tigmit/Split-Numpad/Documentation/esp32-wroom-32.jpg.webp

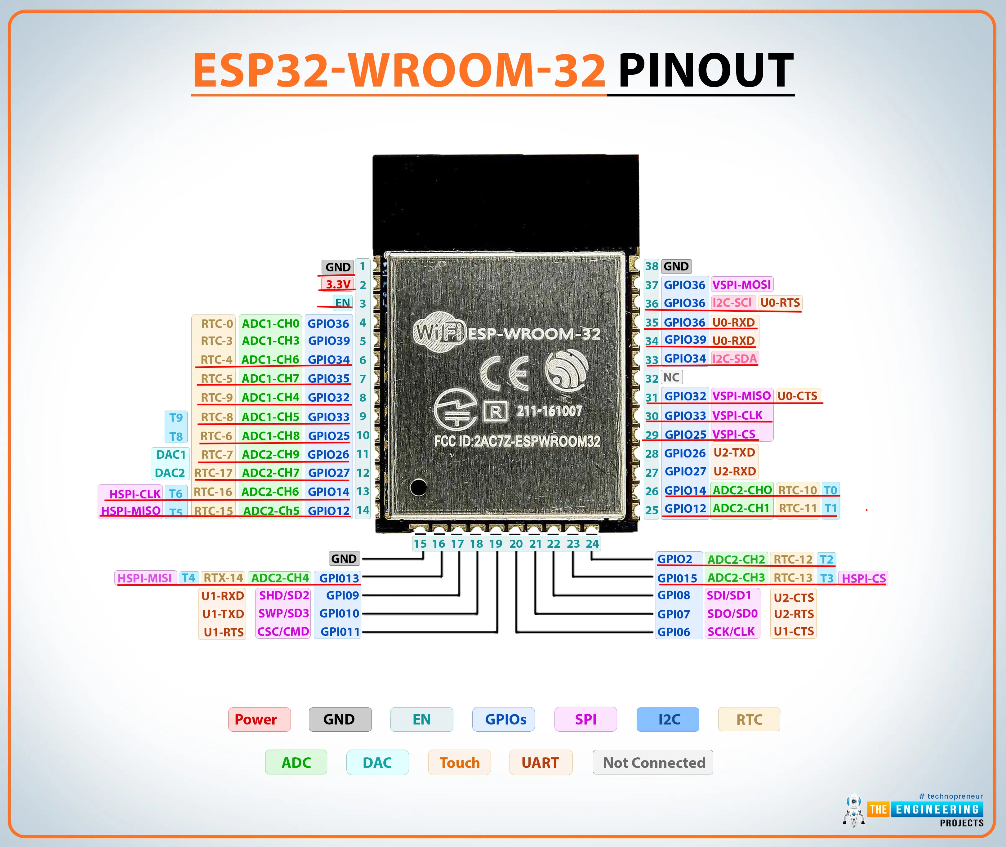
Documentation/esp32-wroom-32.jpg.webp
