tigmit/Split-Numpad/Documentation/numpad3dView.png

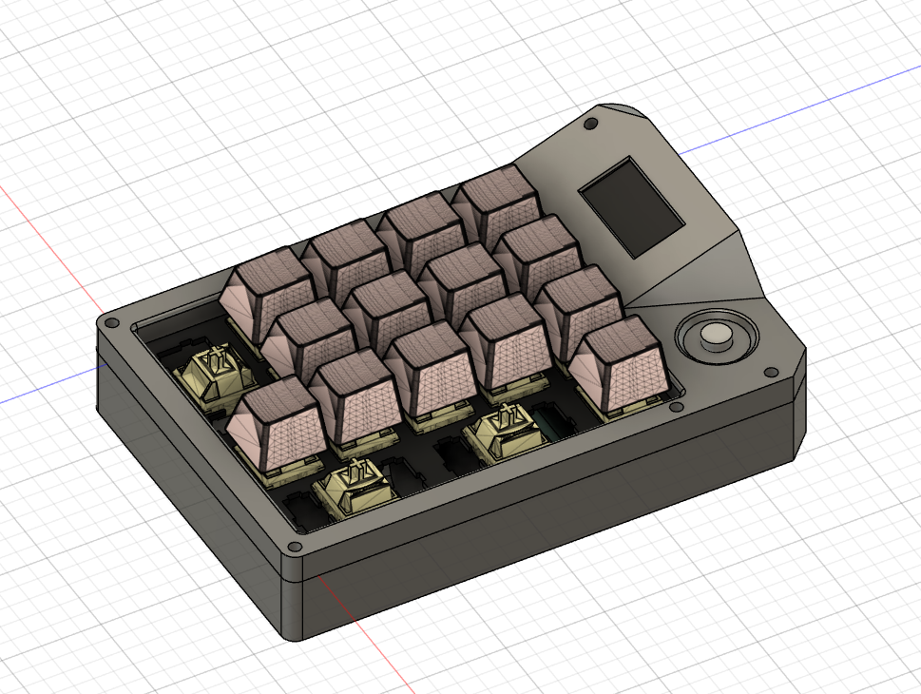
Documentation/numpad3dView.png
