tigmit/Split-Numpad/README.md

# DIY NUMPAD -
#####    by TIGMIT

exampleImmage
