tigmit/Split-Numpad/Documentation/M3_Bolt_Countersink_Dimentions.webp

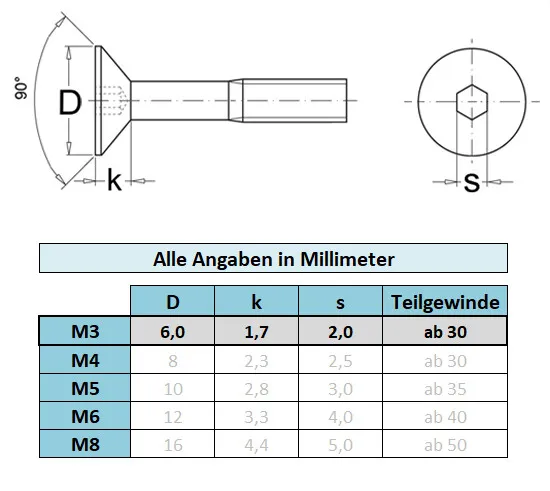
Documentation/M3_Bolt_Countersink_Dimentions.webp
