tigmit/Split-Numpad/Documentation/M3_Bolt_Dimentions.webp

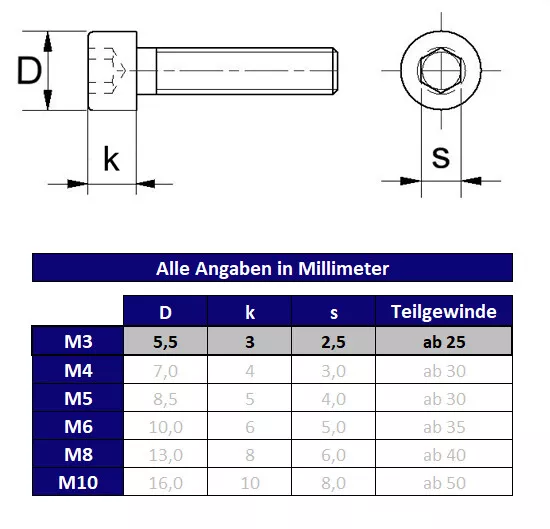
Documentation/M3_Bolt_Dimentions.webp
