tigmit/Split-Numpad/case_Design/Exports/numPadCase-keyplate.step

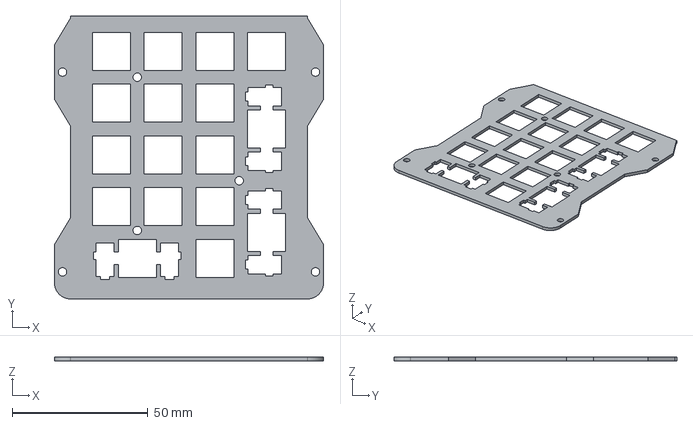
[picture p5: CAD file, 2024-10-12]
case_Design/Exports/numPadCase-keyplate.step
99.1 x 104.2 x 1.50 mm
