tigmit/Split-Numpad/Documentation/keyplate_MX_ONLY.dxf

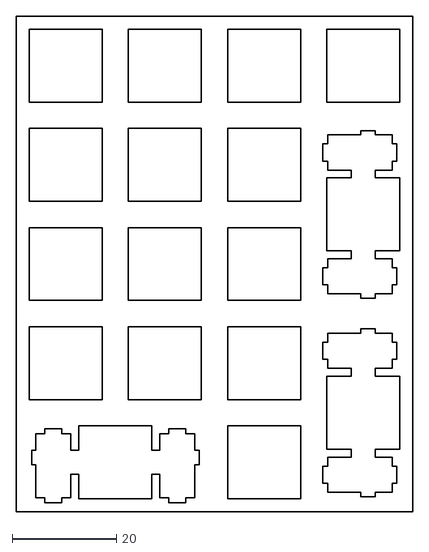
[picture p6: CAD file, 2024-09-06]
Documentation/keyplate_MX_ONLY.dxf
76.2 x 95.2
