tigmit/Split-Numpad/Power_Delivery_Module_V2/PowerDeliveryModule_V2/PowerDeliveryModule_V2.step

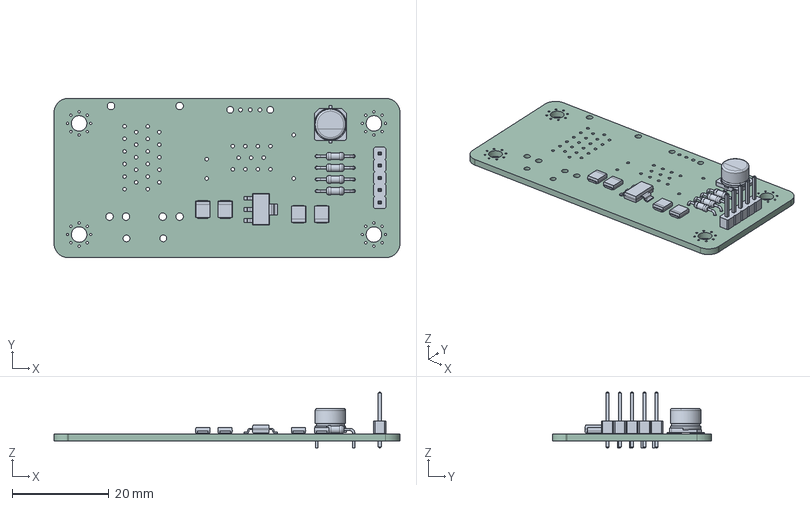
[picture p7: CAD file, 2024-09-06]
Power_Delivery_Module_V2/PowerDeliveryModule_V2/PowerDeliveryModule_V2.step
71.6 x 33.0 x 11.5 mm
CP_EIA-3528-12_Kemet-T x 4
R_Axial_DIN0204_L3.6mm_D1.6mm_P7.62mm_Horizontal x 4
CP_Elec_6.3x5.2
PinHeader_1x05_P2.54mm_Vertical
SOT-223
PowerDeliveryModule_V2_PCB
