tigmit/Split-Numpad/case_Design/Exports/numPadCase-Lid.stl

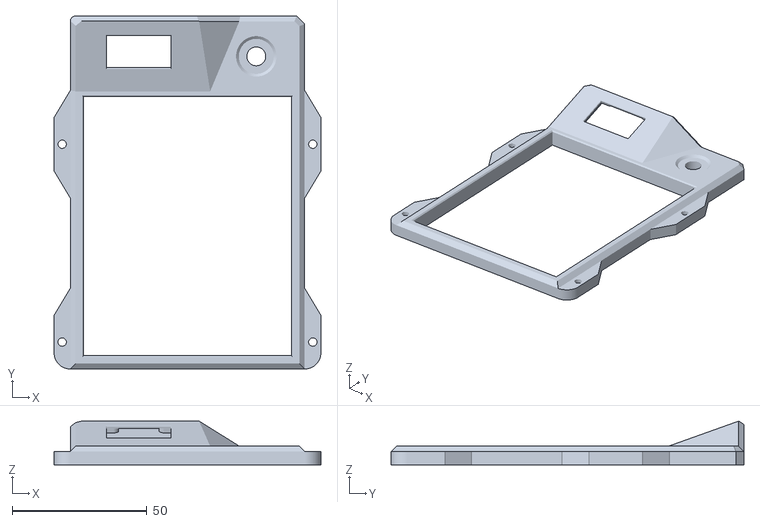
[picture p8: CAD file, 2024-10-12]
case_Design/Exports/numPadCase-Lid.stl
99.1 x 131.2 x 16.3
