tigmit/Split-Numpad/Documentation/PowerDeliveryBoard v2.step

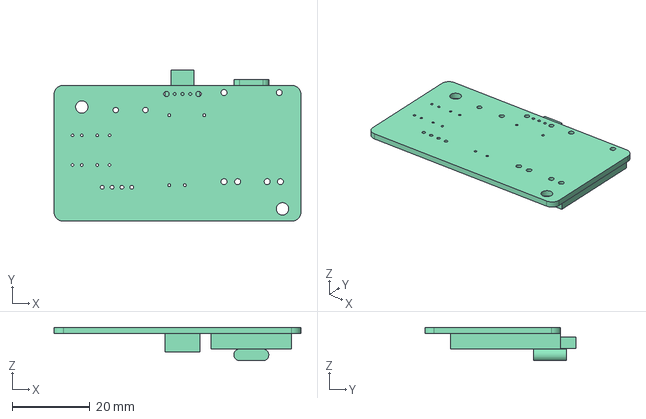
[picture p9: CAD file, 2024-07-21]
Documentation/PowerDeliveryBoard v2.step
63.5 x 38.9 x 8.60 mm
