tigmit/Split-Numpad/case_Design/Exports/numPadCase-uartLid.stl

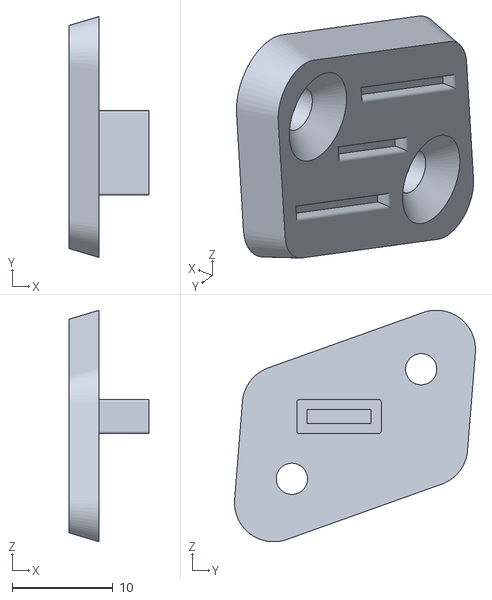
[picture p10: CAD file, 2024-10-12]
case_Design/Exports/numPadCase-uartLid.stl
8.00 x 24.0 x 23.0
