tigmit/Split-Numpad/Documentation/numpadPlate.dxf

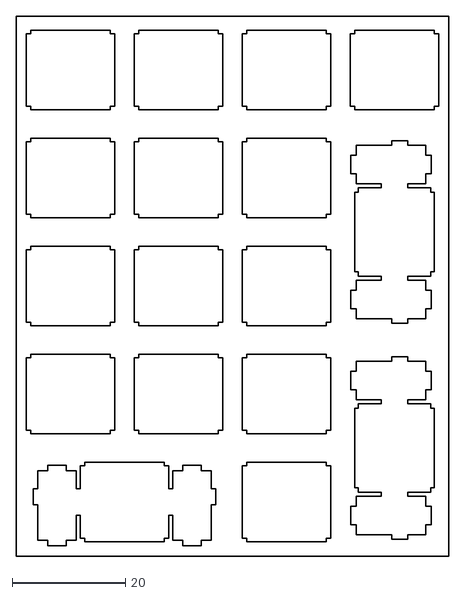
[picture p11: CAD file, 2024-07-21]
Documentation/numpadPlate.dxf
76.2 x 95.2
