tigmit/Split-Numpad/case_Design/Exports/numPadCase-bottomCase.stl

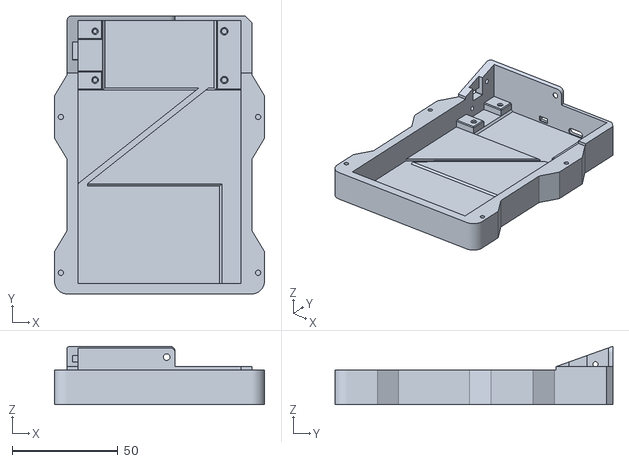
[picture p12: CAD file, 2024-10-12]
case_Design/Exports/numPadCase-bottomCase.stl
99.1 x 131.2 x 27.6
