tigmit/Split-Numpad/(list of files, cad)

Other CAD files:
case_Design/Exports/numPadCase-keyplate.dxf
case_Design/Exports/numPadCase-keyplate.stl
