tigmit/Split-Numpad/numpad_Schematics/numpad.kicad_pcb

## KiCad design numpad_Schematics/numpad.kicad_pcb (2024-10-12)

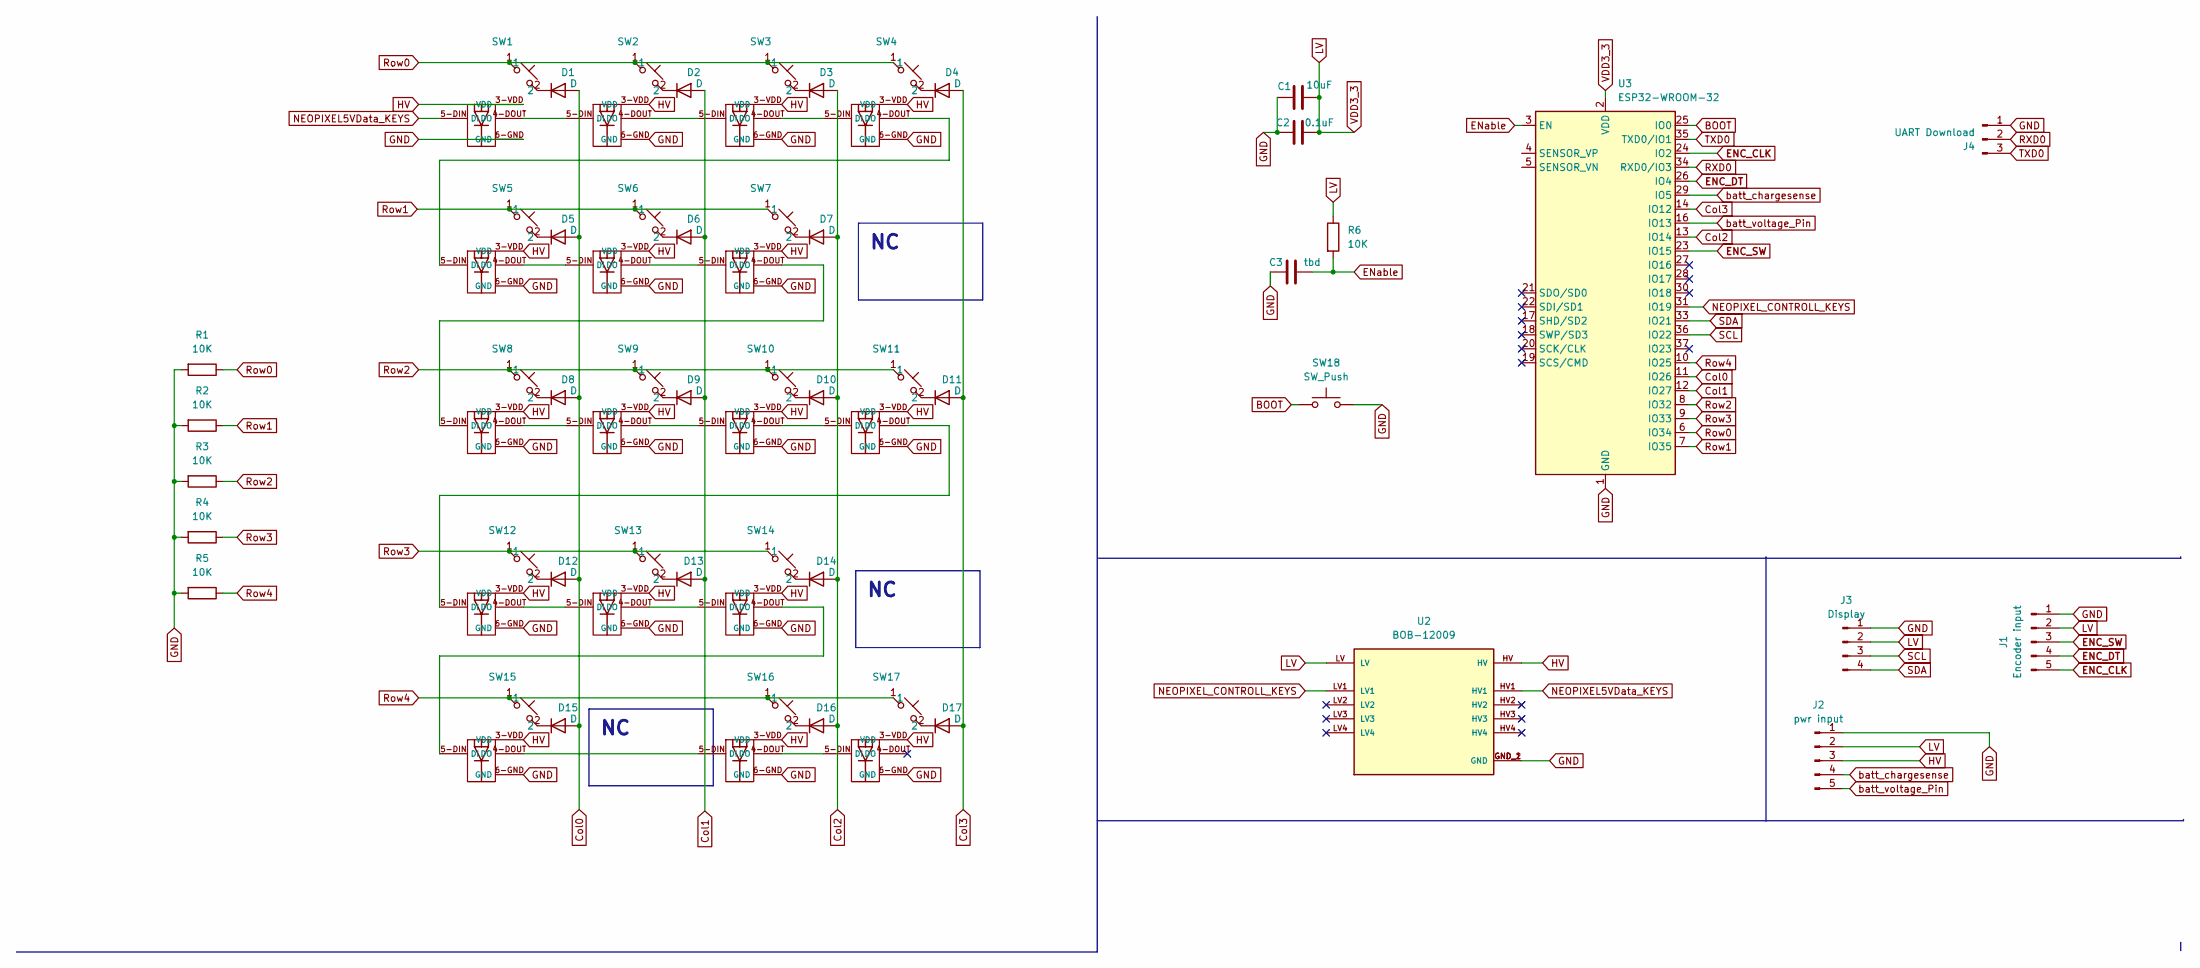
[picture p13: schematic numpad.kicad_sch]

Parts:
C1: 10uF; CP_EIA-3528-12_Kemet-T
C2: 0.1uF; CP_EIA-3528-12_Kemet-T
C3: tbd; CP_EIA-3528-12_Kemet-T
D1, D2, D3, D4, D5, D6, D7, D8, D9, D10, D11, D12, D13, D14, D15, D16, D17: D; Diode_SOD-123
J1: Encoder input; PinHeader_1x05_P2.54mm_Vertical
J2: pwr input; PinHeader_1x05_P2.54mm_Vertical
J3: Display; PinHeader_1x04_P2.54mm_Vertical
J4: UART Download; PinHeader_1x03_P2.54mm_Horizontal
R1, R2, R3, R4, R5, R6: 10K; R_Axial_DIN0204_L3.6mm_D1.6mm_P7.62mm_Horizontal
SW1, SW2, SW3, SW4, SW5, SW6, SW7, SW8, SW9, SW10, SW11, SW12, SW13, SW14, SW15, SW16, SW17: hotswap socket with neopixel
SW18: SW_Push; tigmit pushbutton
U2: BOB-12009; CONV_BOB-12009; PARTREV 01
U3: ESP32-WROOM-32; ESP32-WROOM-32 tigmit

Connections:
BOOT: SW18.1, U3.25 (IO0)
Col0: D1.2 (A), D5.2 (A), D8.2 (A), D12.2 (A), D15.2 (A), U3.11 (IO26)
Col1: D2.2 (A), D6.2 (A), D9.2 (A), D13.2 (A), U3.12 (IO27)
Col2: D3.2 (A), D7.2 (A), D10.2 (A), D14.2 (A), D16.2 (A), U3.13 (IO14)
Col3: D4.2 (A), D11.2 (A), D17.2 (A), U3.14 (IO12)
ENC_CLK: J1.5, U3.24 (IO2); also elsewhere on the board
ENC_DT: J1.4, U3.26 (IO4); also elsewhere on the board
ENC_SW: J1.3, U3.23 (IO15); also elsewhere on the board
ENable: C3.2, R6.2, U3.3 (EN)
GND: C1.1, C2.1, C3.1, J1.1, J2.1, J3.1, J4.1, R1.2, R2.2, R3.2, R4.2, R5.2, SW1.6-GND (GND), SW2.6-GND (GND), SW3.6-GND (GND), SW4.6-GND (GND), SW5.6-GND (GND), SW6.6-GND (GND), SW7.6-GND (GND), SW8.6-GND (GND), SW9.6-GND (GND), SW10.6-GND (GND), SW11.6-GND (GND), SW12.6-GND (GND), SW13.6-GND (GND), SW14.6-GND (GND), SW15.6-GND (GND), SW16.6-GND (GND), SW17.6-GND (GND), SW18.2, U2.GND_1 (GND), U2.GND_2 (GND), U3.1 (GND), U3.15 (GND), U3.38 (GND), U3.39 (GND); also elsewhere on the board
HV: J2.3, SW1.3-VDD (VDD), SW2.3-VDD (VDD), SW3.3-VDD (VDD), SW4.3-VDD (VDD), SW5.3-VDD (VDD), SW6.3-VDD (VDD), SW7.3-VDD (VDD), SW8.3-VDD (VDD), SW9.3-VDD (VDD), SW10.3-VDD (VDD), SW11.3-VDD (VDD), SW12.3-VDD (VDD), SW13.3-VDD (VDD), SW14.3-VDD (VDD), SW15.3-VDD (VDD), SW16.3-VDD (VDD), SW17.3-VDD (VDD), U2.HV; also elsewhere on the board
LV: C1.2, C2.2, J1.2, J2.2, J3.2, R6.1, U2.LV, U3.2 (VDD); also elsewhere on the board
NEOPIXEL5VData_KEYS: SW1.5-DIN (DI), U2.HV1; also elsewhere on the board
NEOPIXEL_CONTROLL_KEYS: U2.LV1, U3.31 (IO19); also elsewhere on the board
unnamed: D1.1 (K), SW1.2
unnamed: D2.1 (K), SW2.2
unnamed: D3.1 (K), SW3.2
unnamed: D4.1 (K), SW4.2
unnamed: D5.1 (K), SW5.2
unnamed: D6.1 (K), SW6.2
unnamed: D7.1 (K), SW7.2
unnamed: D8.1 (K), SW8.2
unnamed: D9.1 (K), SW9.2
unnamed: D10.1 (K), SW10.2
unnamed: D11.1 (K), SW11.2
unnamed: D12.1 (K), SW12.2
unnamed: D13.1 (K), SW13.2
unnamed: D14.1 (K), SW14.2
unnamed: D15.1 (K), SW15.2
unnamed: D16.1 (K), SW16.2
unnamed: D17.1 (K), SW17.2
unnamed: SW1.4-DOUT (DO), SW2.5-DIN (DI)
unnamed: SW2.4-DOUT (DO), SW3.5-DIN (DI)
unnamed: SW3.4-DOUT (DO), SW4.5-DIN (DI)
unnamed: SW4.4-DOUT (DO), SW5.5-DIN (DI)
unnamed: SW5.4-DOUT (DO), SW6.5-DIN (DI)
unnamed: SW6.4-DOUT (DO), SW7.5-DIN (DI)
unnamed: SW7.4-DOUT (DO), SW8.5-DIN (DI)
unnamed: SW8.4-DOUT (DO), SW9.5-DIN (DI)
unnamed: SW9.4-DOUT (DO), SW10.5-DIN (DI)
unnamed: SW10.4-DOUT (DO), SW11.5-DIN (DI)
unnamed: SW11.4-DOUT (DO), SW12.5-DIN (DI)
unnamed: SW12.4-DOUT (DO), SW13.5-DIN (DI)
unnamed: SW13.4-DOUT (DO), SW14.5-DIN (DI)
unnamed: SW14.4-DOUT (DO), SW15.5-DIN (DI)
unnamed: SW15.4-DOUT (DO), SW16.5-DIN (DI)
unnamed: SW16.4-DOUT (DO), SW17.5-DIN (DI)
RXD0: J4.2, U3.34 (RXD0/IO3); also elsewhere on the board
Row0: R1.1, SW1.1, SW2.1, SW3.1, SW4.1, U3.6 (IO34)
Row1: R2.1, SW5.1, SW6.1, SW7.1, U3.7 (IO35)
Row2: R3.1, SW8.1, SW9.1, SW10.1, SW11.1, U3.8 (IO32)
Row3: R4.1, SW12.1, SW13.1, SW14.1, U3.9 (IO33)
Row4: R5.1, SW15.1, SW16.1, SW17.1, U3.10 (IO25)
SCL: J3.3, U3.36 (IO22); also elsewhere on the board
SDA: J3.4, U3.33 (IO21); also elsewhere on the board
TXD0: J4.3, U3.35 (TXD0/IO1); also elsewhere on the board
batt_chargesense: J2.4, U3.29 (IO5); also elsewhere on the board
batt_voltage_Pin: J2.5, U3.16 (IO13); also elsewhere on the board

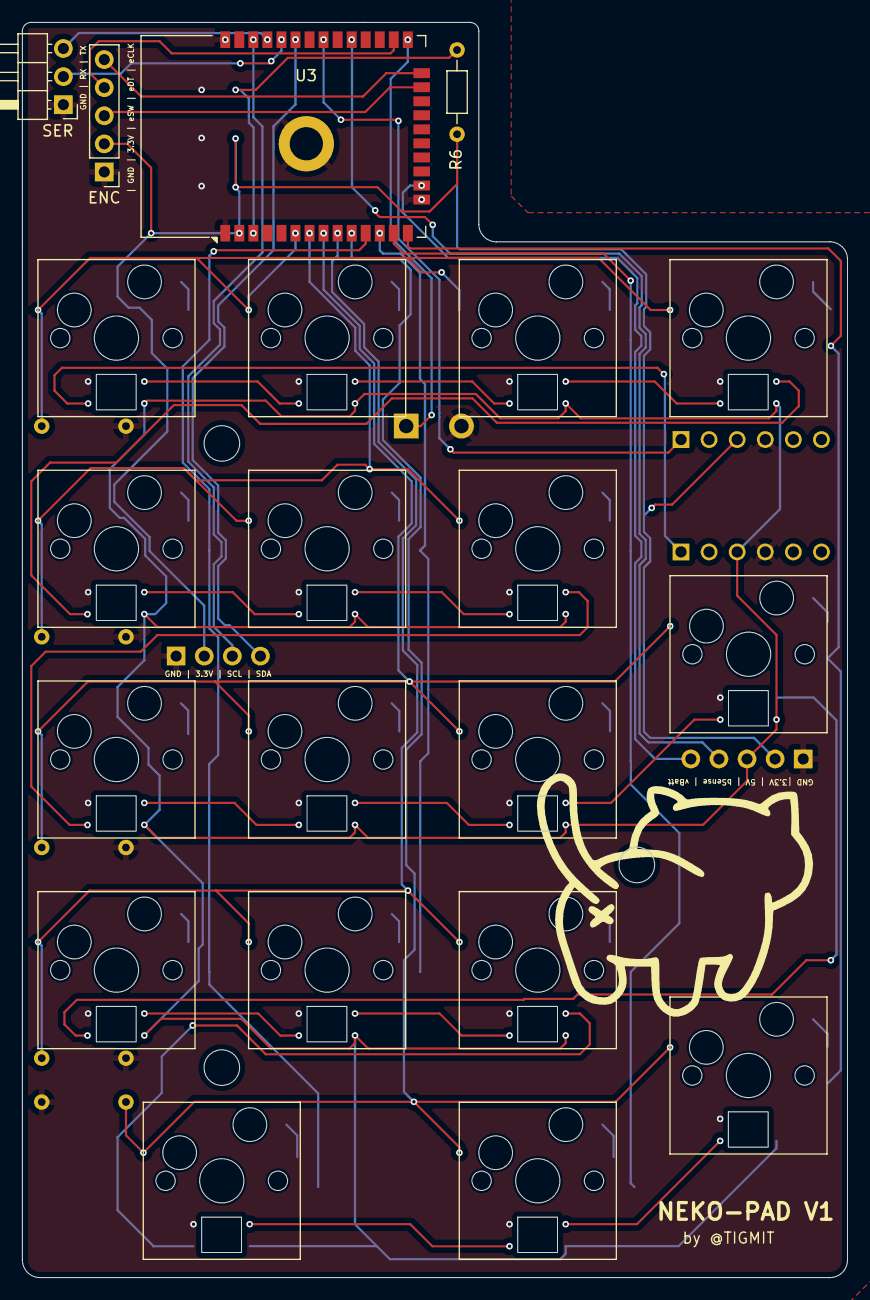
[picture p14: board numpad.kicad_pcb from above]

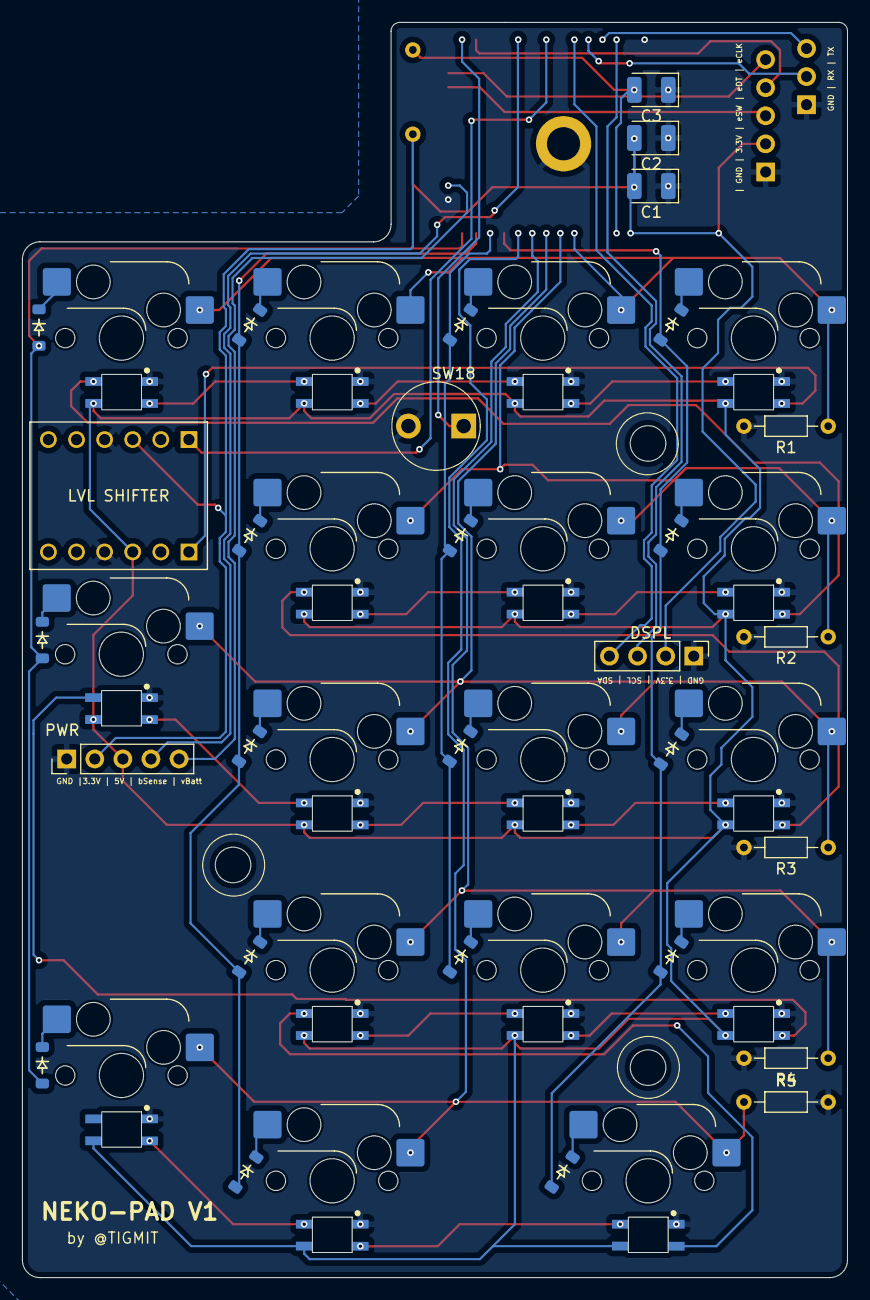
[picture p15: board numpad.kicad_pcb from below]

Board: 11 copper layers, 74.6 x 113.5 mm, 50 parts (29 on the bottom side), 58 nets.

Other parts of the board:
DSPL: Display; PinHeader_1x04_P2.54mm_Vertical
ENC: Encoder input; PinHeader_1x05_P2.54mm_Vertical
LVL SHIFTER: BOB-12009; CONV_BOB-12009
PWR: pwr input; PinHeader_1x05_P2.54mm_Vertical
SER: UART Download; PinHeader_1x03_P2.54mm_Horizontal

Their connections:
ENC_CLK: ENC.5; also elsewhere on the board
ENC_DT: ENC.4; also elsewhere on the board
ENC_SW: ENC.3; also elsewhere on the board
GND: DSPL.1, ENC.1, LVL SHIFTER.GND_1 (GND), LVL SHIFTER.GND_2 (GND), PWR.1, SER.1; also elsewhere on the board
HV: LVL SHIFTER.HV, PWR.3; also elsewhere on the board
LV: DSPL.2, ENC.2, LVL SHIFTER.LV, PWR.2; also elsewhere on the board
NEOPIXEL5VData_KEYS: LVL SHIFTER.HV1; also elsewhere on the board
NEOPIXEL_CONTROLL_KEYS: LVL SHIFTER.LV1; also elsewhere on the board
RXD0: SER.2; also elsewhere on the board
SCL: DSPL.3; also elsewhere on the board
SDA: DSPL.4; also elsewhere on the board
TXD0: SER.3; also elsewhere on the board
batt_chargesense: PWR.4; also elsewhere on the board
batt_voltage_Pin: PWR.5; also elsewhere on the board
