tigmit/Split-Numpad/Power_Delivery_Module_V2/PowerDeliveryModule_V2/PowerDeliveryModule_V2.kicad_pcb

## KiCad design Power_Delivery_Module_V2/PowerDeliveryModule_V2/PowerDeliveryModule_V2.kicad_pcb (2024-09-06)

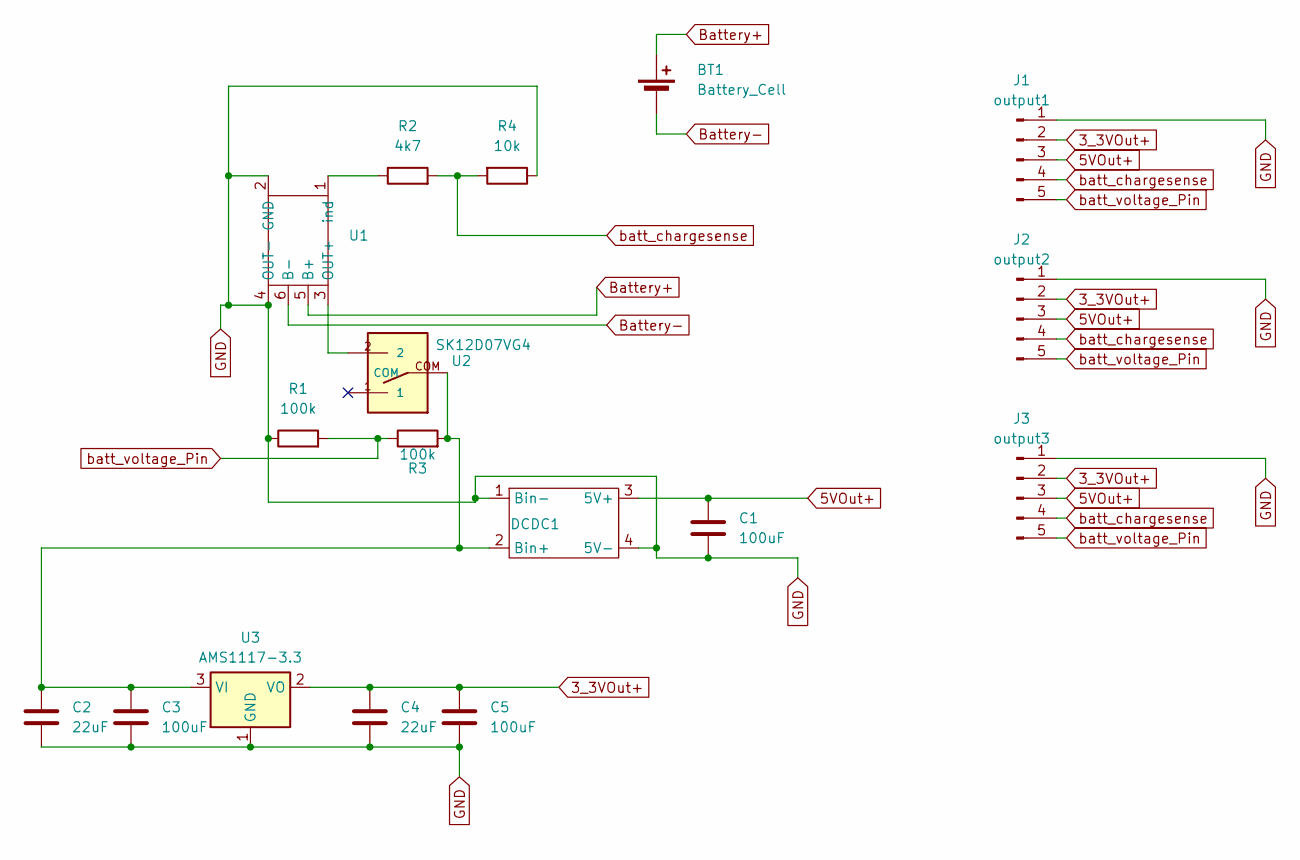
[picture p16: schematic PowerDeliveryModule_V2.kicad_sch]

Parts:
BT1: Battery_Cell; battery solder pins
C1, C3, C5: 100uF; CP_EIA-3528-12_Kemet-T
C2, C4: 22uF; CP_EIA-3528-12_Kemet-T
DCDC1: DCDC-Converter
J1: output1; PinHeader_1x05_P2.54mm_Vertical
J2: output2; PinHeader_1x05_P2.54mm_Vertical
J3: output3; PinHeader_1x05_P2.54mm_Vertical
R1, R3: 100k; R_Axial_DIN0204_L3.6mm_D1.6mm_P7.62mm_Horizontal
R2: 4k7; R_Axial_DIN0204_L3.6mm_D1.6mm_P7.62mm_Horizontal
R4: 10k; R_Axial_DIN0204_L3.6mm_D1.6mm_P7.62mm_Horizontal
U1: TP4056-18650
U2: SK12D07VG4
U3: AMS1117-3.3; SOT-223-3_TabPin2

Connections:
3_3VOut+: C4.1, C5.1, J1.2, J2.2, J3.2, U3.2 (VO)
5VOut+: C1.1, DCDC1.3 (5V+), J1.3, J2.3, J3.3
Battery+: BT1.1 (+), U1.5 (B+)
Battery-: BT1.2 (-), U1.6 (B-)
GND: C1.2, C2.2, C3.2, C4.2, C5.2, DCDC1.1 (Bin-), DCDC1.4 (5V-), J1.1, J2.1, J3.1, R1.1, R4.1, U1.2 (GND), U1.4 (OUT-), U3.1 (GND)
unnamed: C2.1, C3.1, DCDC1.2 (Bin+), R3.2, U2.COM, U3.3 (VI)
unnamed: U1.3 (OUT+), U2.2
unnamed: R2.1, U1.1 (ind)
batt_chargesense: J1.4, J2.4, J3.4, R2.2, R4.2
batt_voltage_Pin: J1.5, J2.5, J3.5, R1.2, R3.1

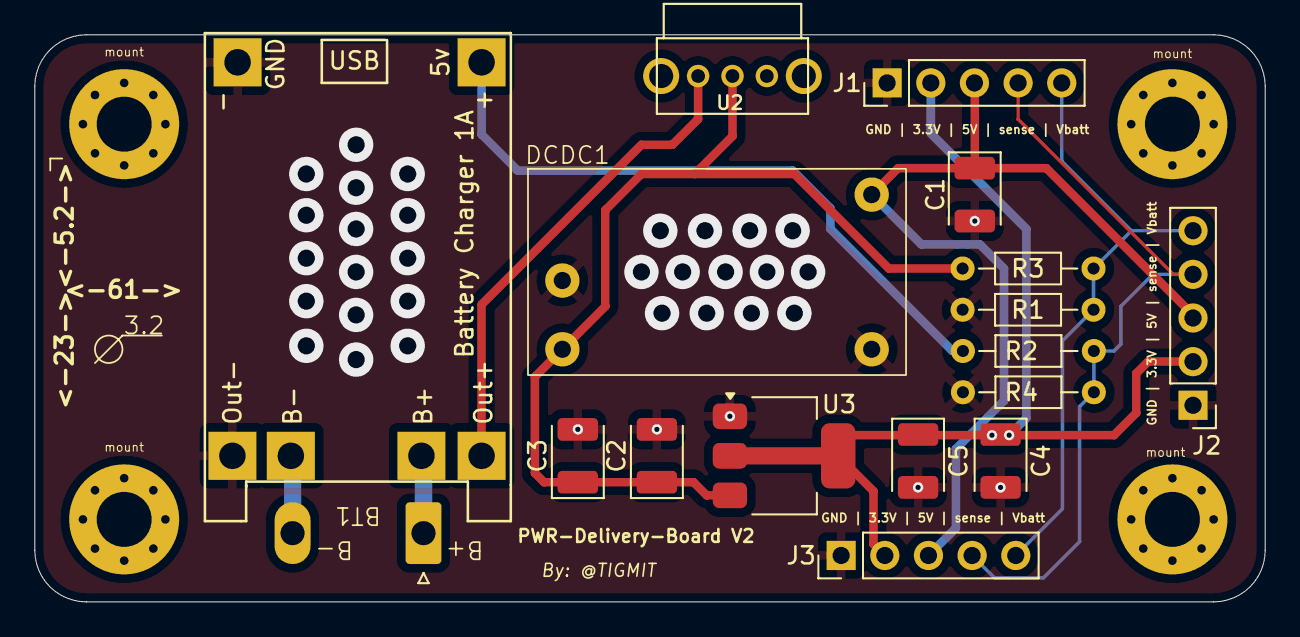
[picture p17: board PowerDeliveryModule_V2.kicad_pcb from above]

Board: 2 copper layers, 71.6 x 33.0 mm, 21 parts (0 on the bottom side), 10 nets.

Other parts of the board:
mount: MountingHole_3.2mm_M3_Pad_Via
mount#2, mount#3, mount#4: MountingHole_3.2mm_M3_Pad_Via
