tigmit/Split-Numpad/Numpad_Code/include/debugSettings.hpp

/**
 * debugSettings.hpp
 * brif    : different debug levels for development and debugging
 * created : 21.07.2024
 * creator : @tigmit
 * Licence : opensource
 */

#pragma once

#undef DEBUG_LVL_1 // shell output row coll press/released
#undef DEBUG_LVL_2 // TBD
#undef DEBUG_LVL_3 // TBD

#undef SOC_PRINT

#undef DISABLE_BLE_OUTPUT
#define FSM_PRINTS_ENABLED
