tigmit/Split-Numpad/(commit log)

2024-07-21 working keyboard matrix and design files
    [PowerDeliveryBoard v2.step, numpad.kicad_pcb, numpad.kicad_sch, numpadPlate.dxf, numpad_case.stl, numpad_lid.stl, numpad_plate_Supported.stl]
2024-08-24 saving basic PCB design
    [numpad.kicad_pcb, numpad.kicad_sch, numpad_PCB_V1.step]
2024-09-06 case and pcb design
    [PowerDeliveryModule_V2.kicad_pcb, PowerDeliveryModule_V2.kicad_sch, PowerDeliveryModule_V2.step, keyplate_MX_ONLY.dxf, numPadCase-keyplate.dxf, numPadCase-keyplate.stl, numpad.kicad_pcb, numpad.kicad_sch]
2024-10-02 case design and some software changes
    [bom.csv, designators.csv, numPadCase-Lid.stl, numPadCase-bottomCase.stl, numPadCase-keyplate.step, numPadCase-uartLid.stl, numpad.kicad_pcb, numpad_PCB_V1.step]
2024-10-12 base functionality including LED DSPL and KEYMATRIX
2024-10-15 implement Battery handling
2024-10-26 ble icon finalized + statechange to placeholder LED controll state
